koushiniku/bv6502/schematics/docs/bv6502_hw.pdf

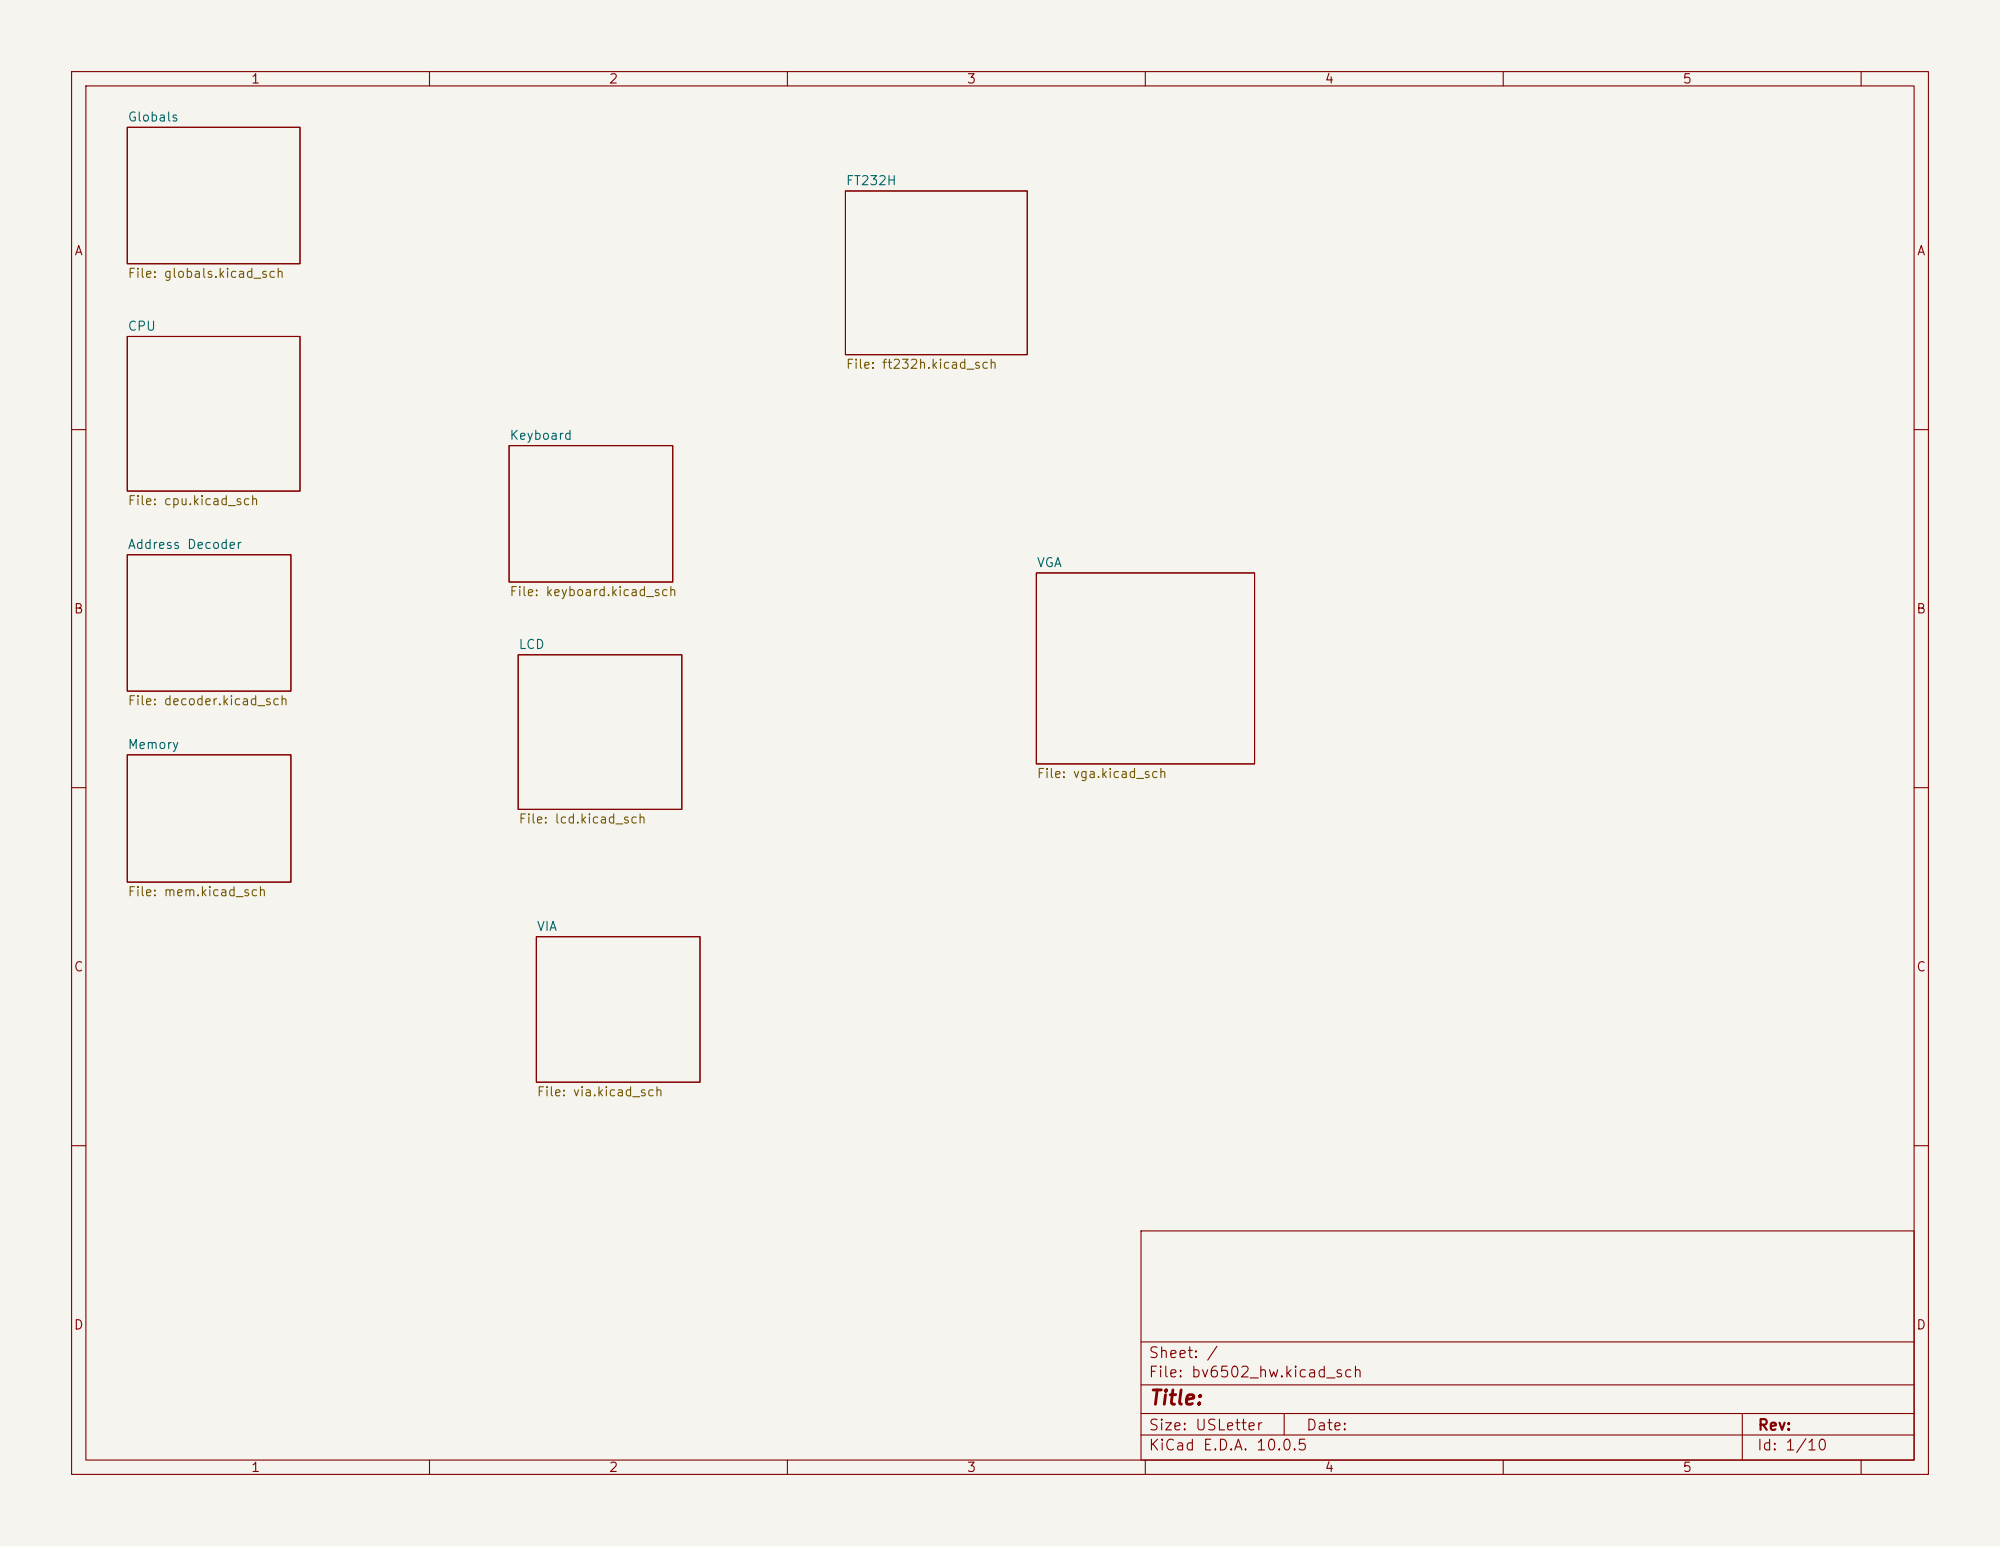
[picture p1: page 1]

Address Decoder File: decoder.kicad_sch Memory File: mem.kicad_sch CPU

Size: USLetter | Rev:
KiCad E.D.A. 10.0.5 | Id: 1/10

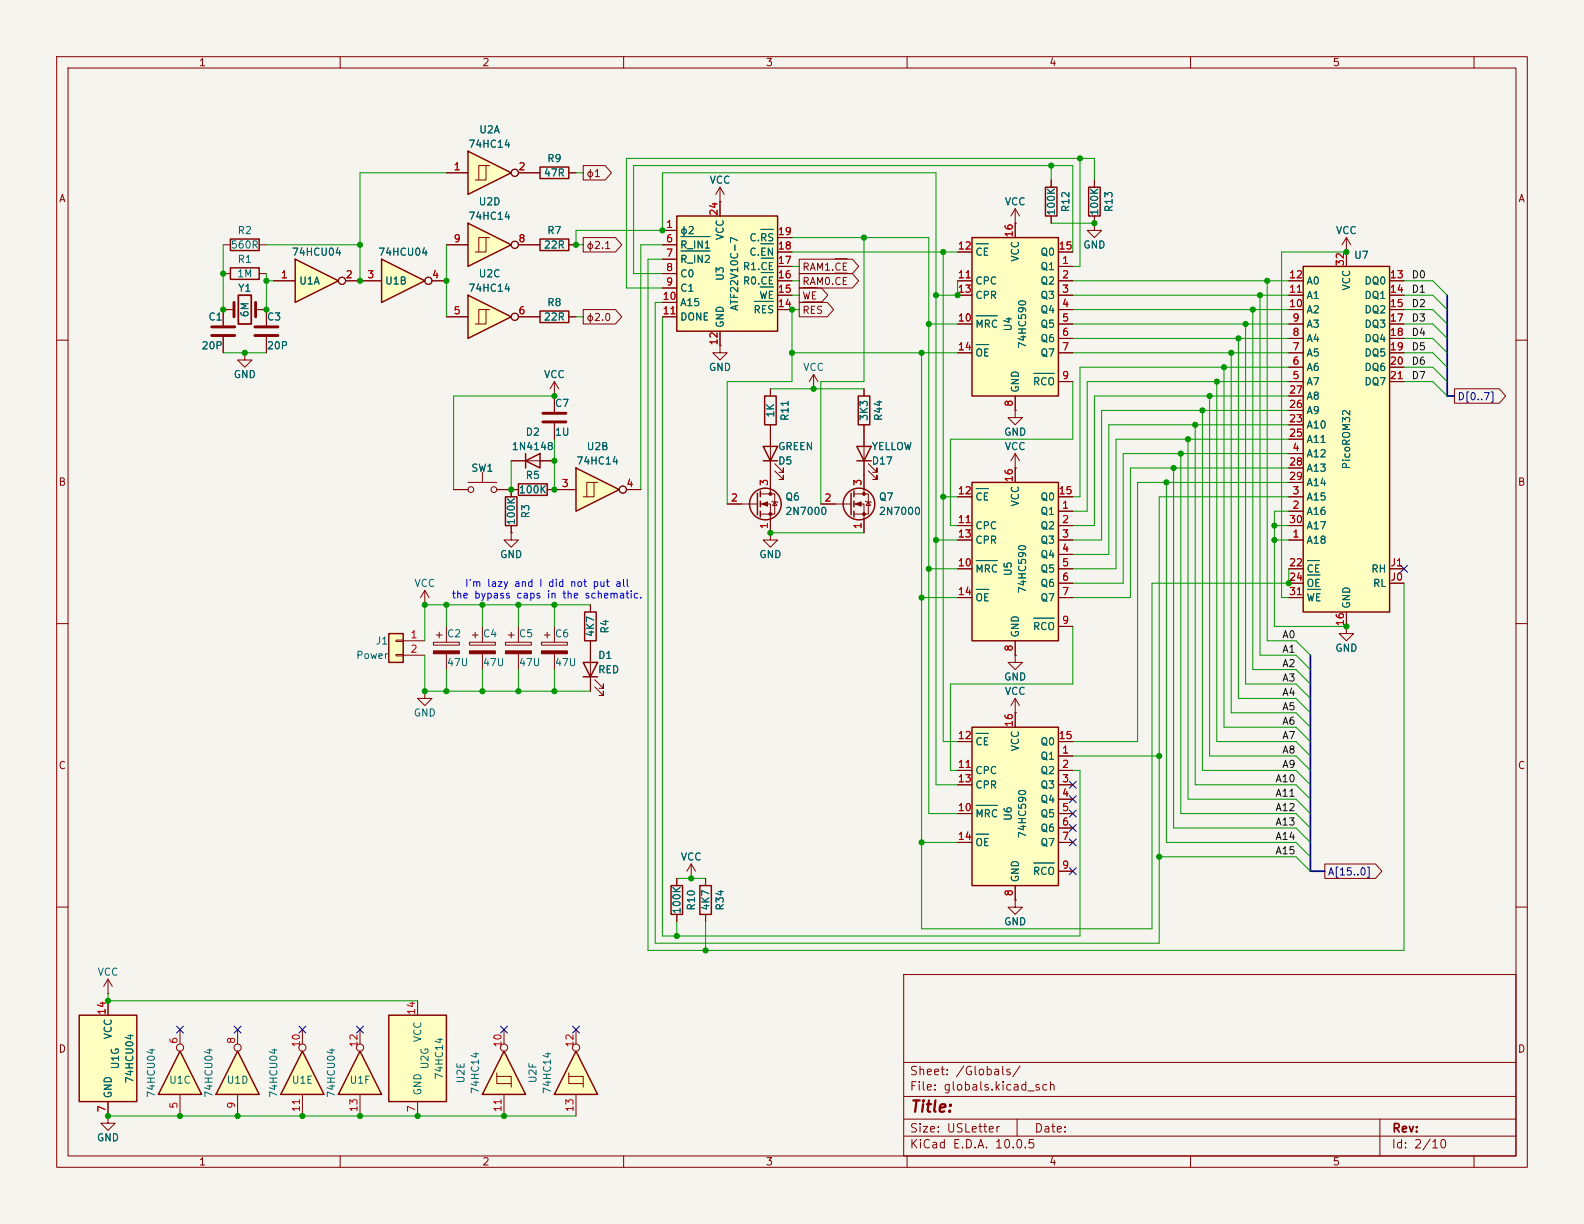
[picture p2: page 2]

A5 7
A6 6
A10 23 OE 24 A10 23 OE 24 A14 29 A14 29

VCC | | | A12 4

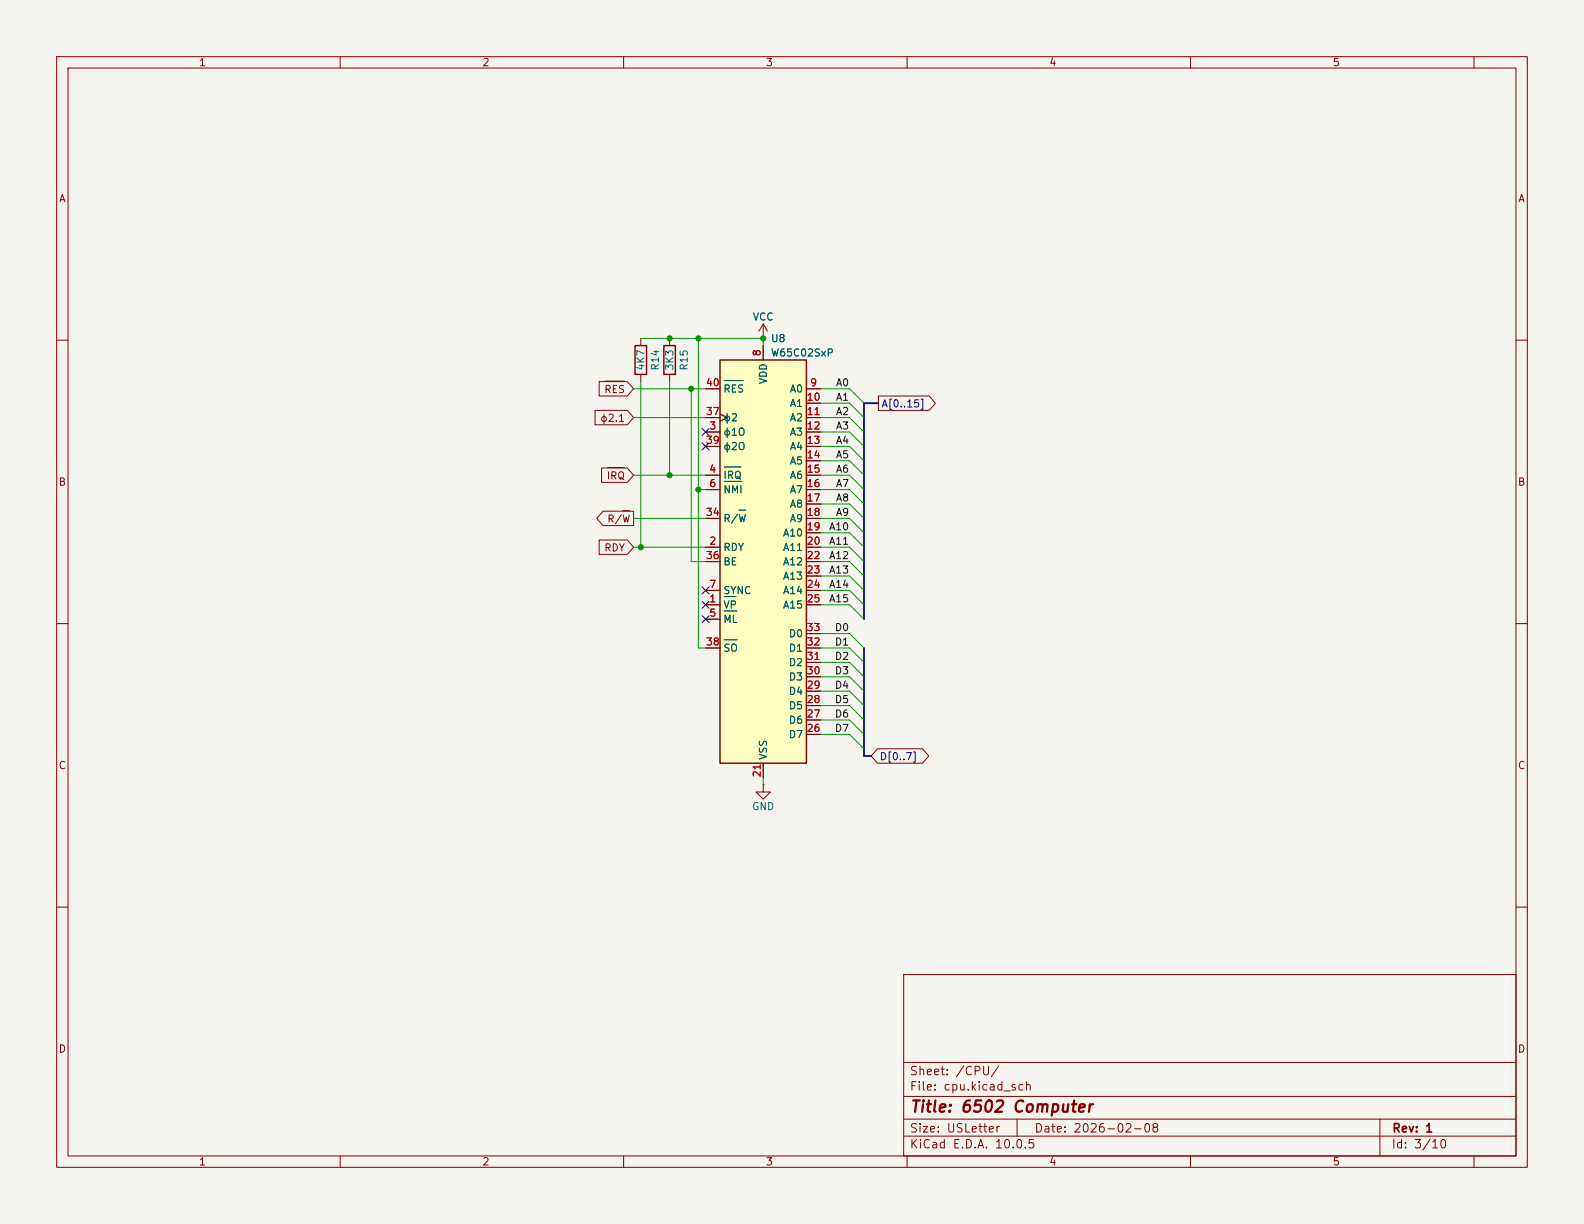
[picture p3: page 3]

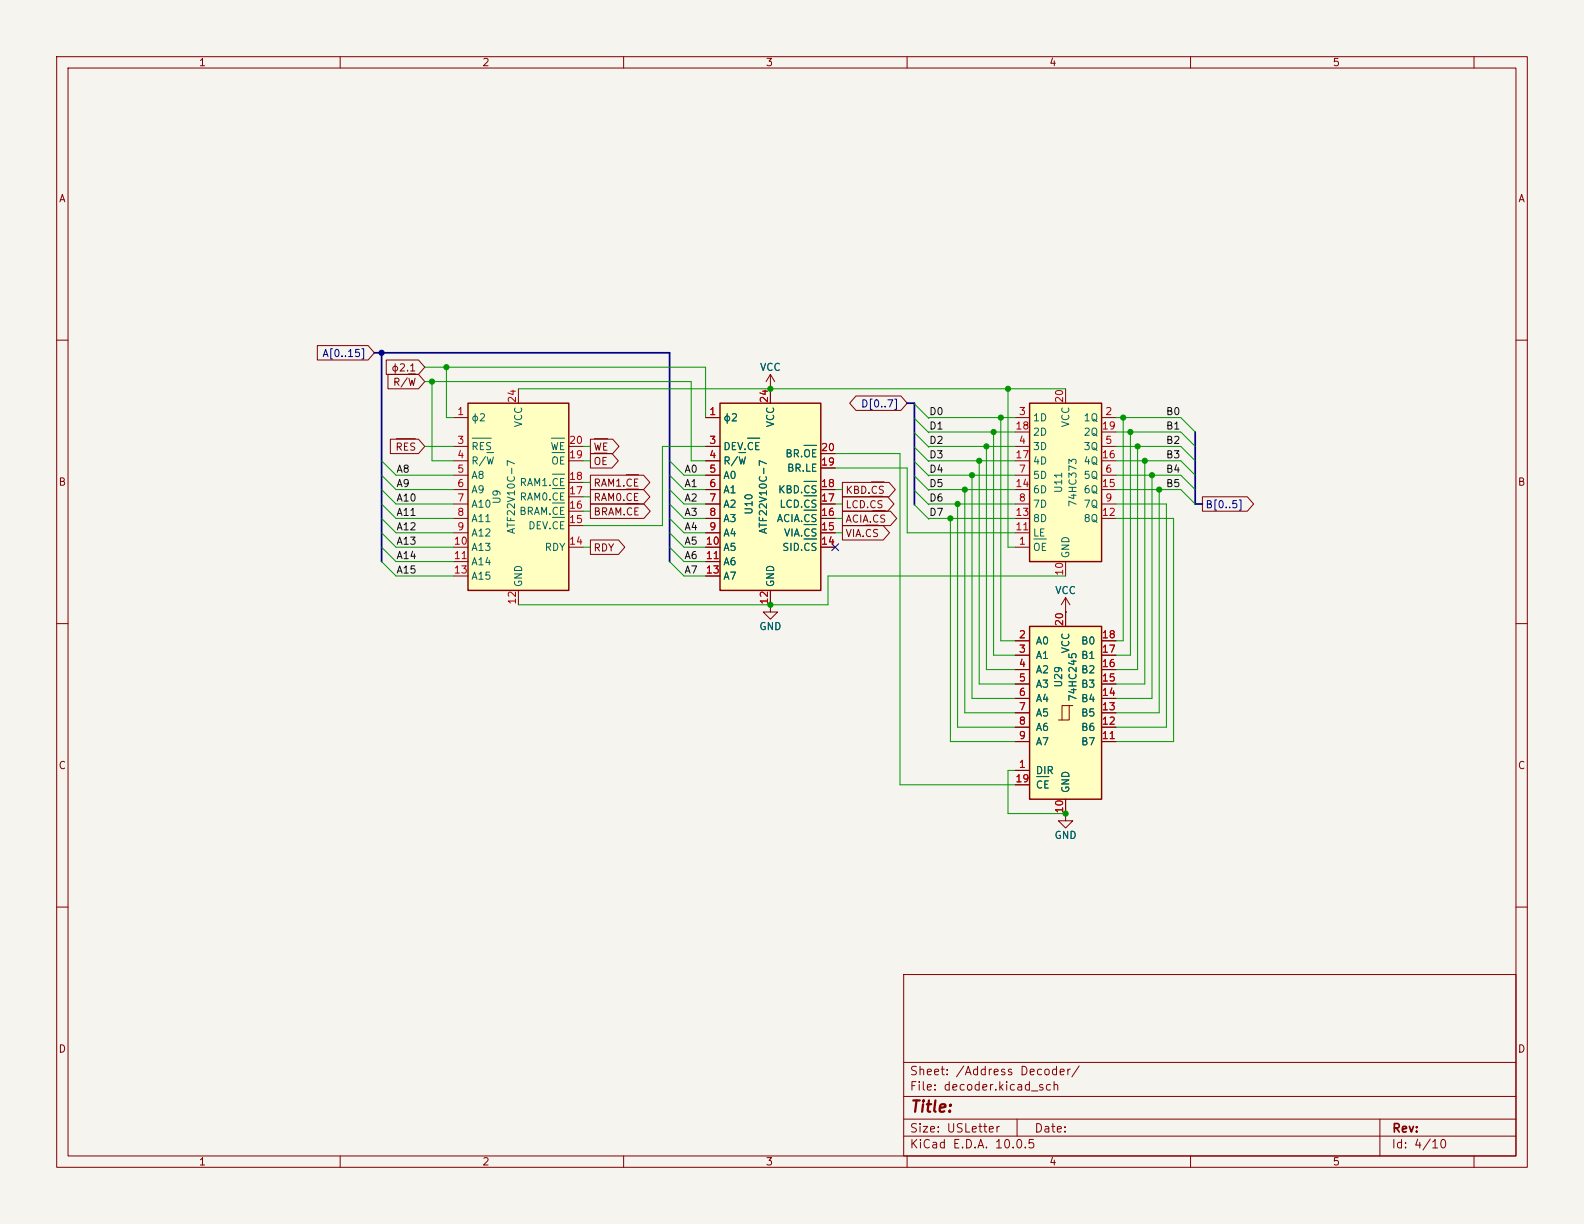
[picture p4: page 4]

VIA.CS D[0..7] RDY RAM1.CE ϕ2.1

VCC
SID.CS 14 VIA.CS 15 ACIA.CS 16 LCD.CS 17 KBD.CS 18 BR.LE 19 BR.OE 20 U10 ATF22V10C-7 GND

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

LCD.CS KBD.CS

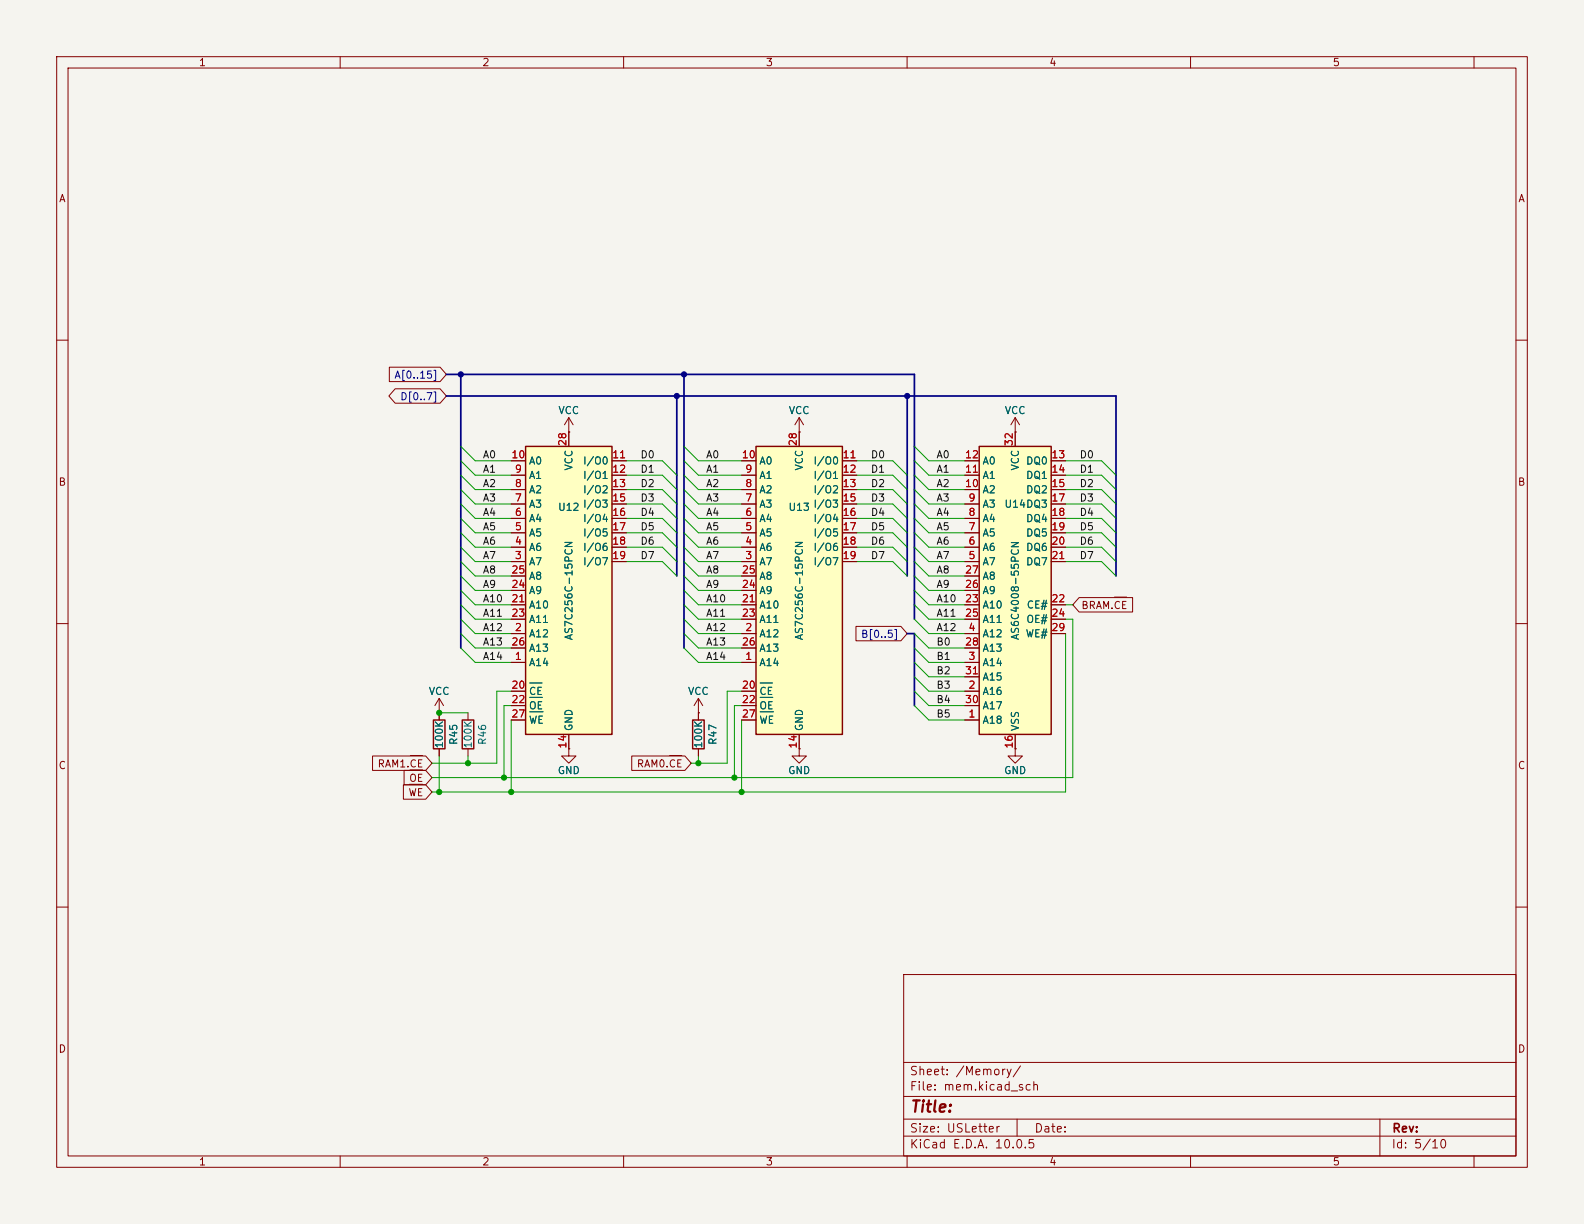
[picture p5: page 5]

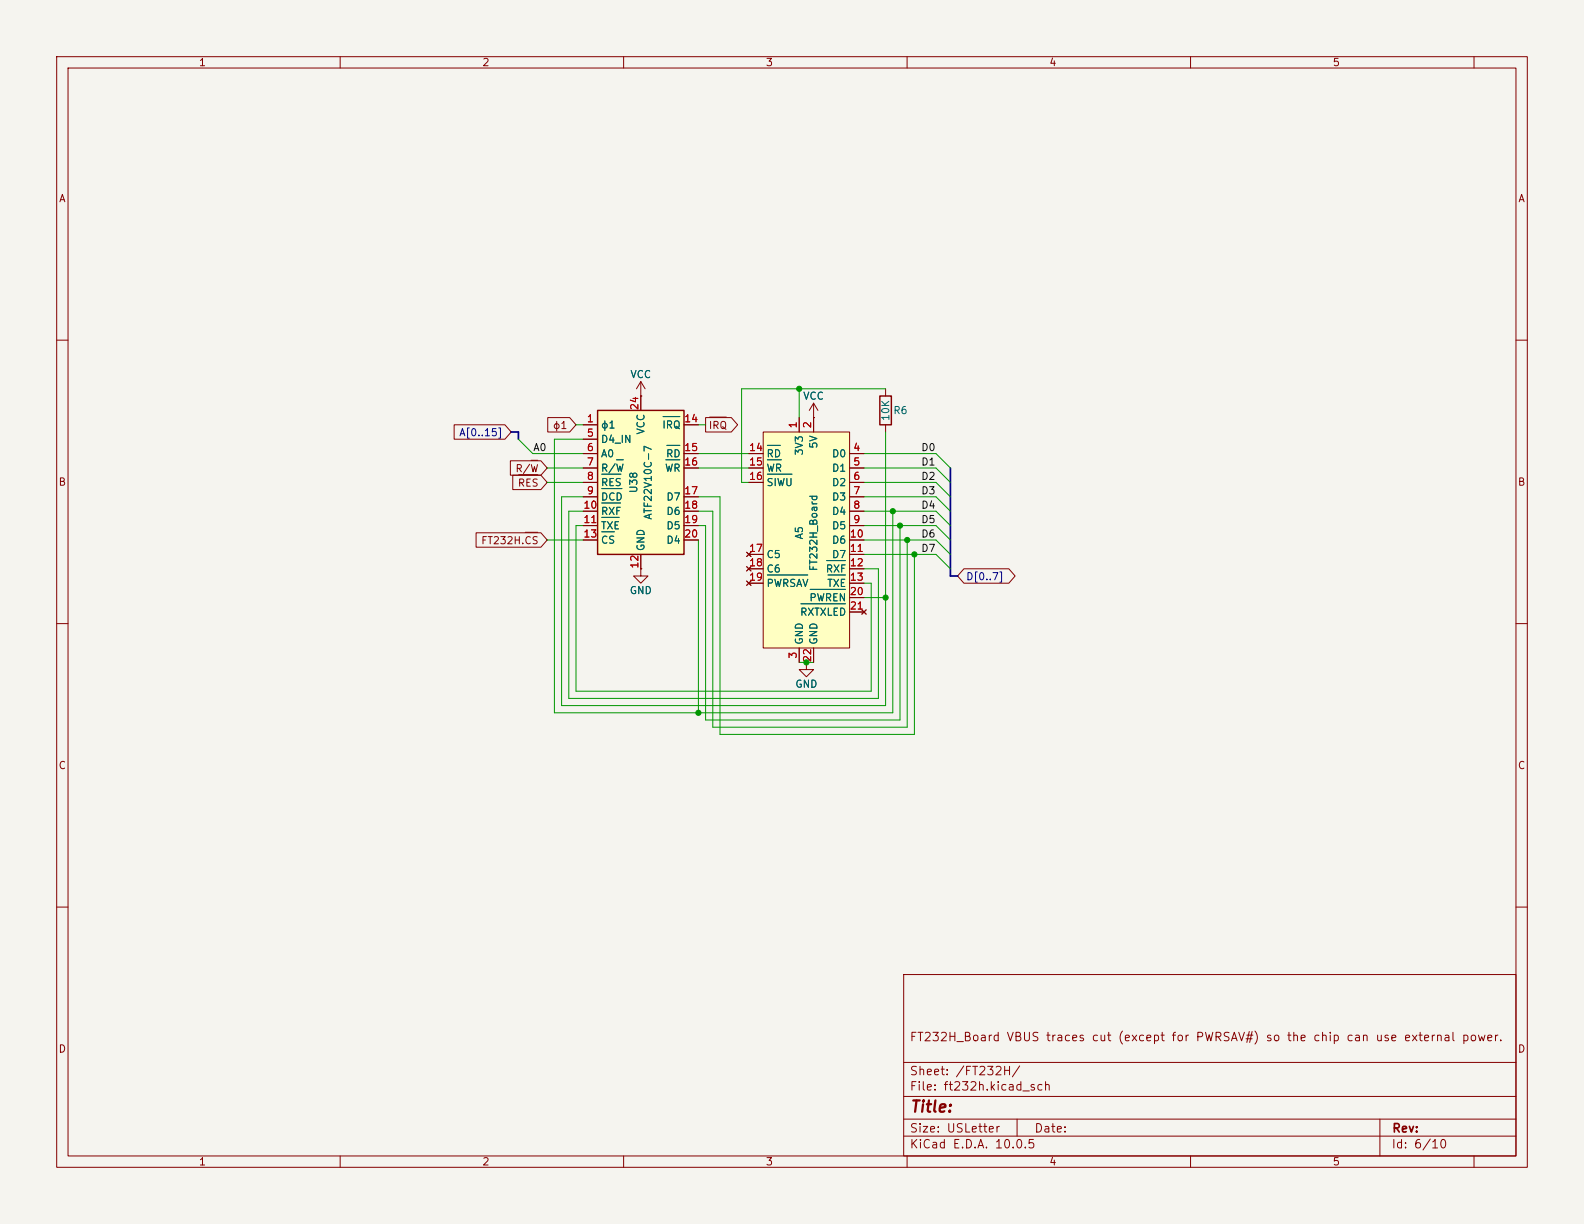
[picture p6: page 6]

VCCGND 12 VCC 24
IRQ 14 RD 15 WR 16 D7 17 D6 18 D5 19 D4 20 U38 ATF22V10C-7 GND

1 RXTXLED 21 GND U38 ATF22V10C-7 GND 12 VCC 24

FT232H_Board VBUS traces cut (except for PWRSAV#) so the chip can use external power. 5V 2 GND

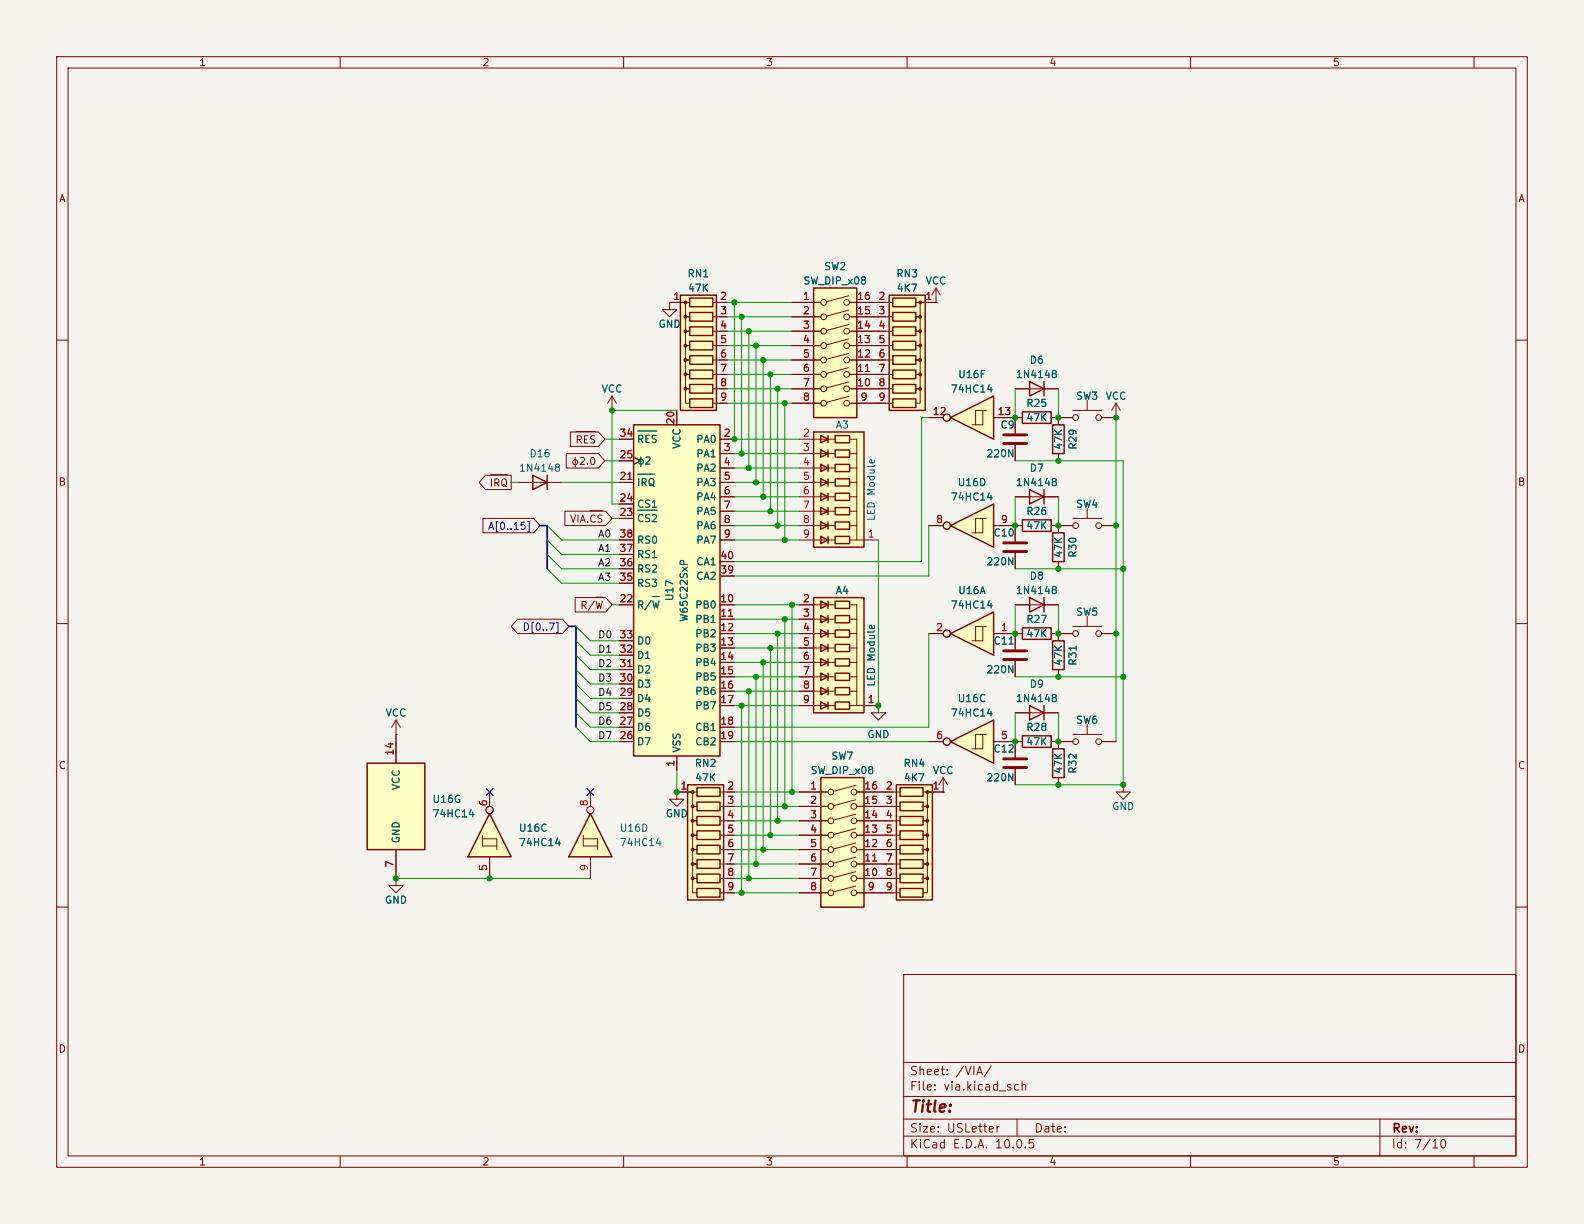
[picture p7: page 7]

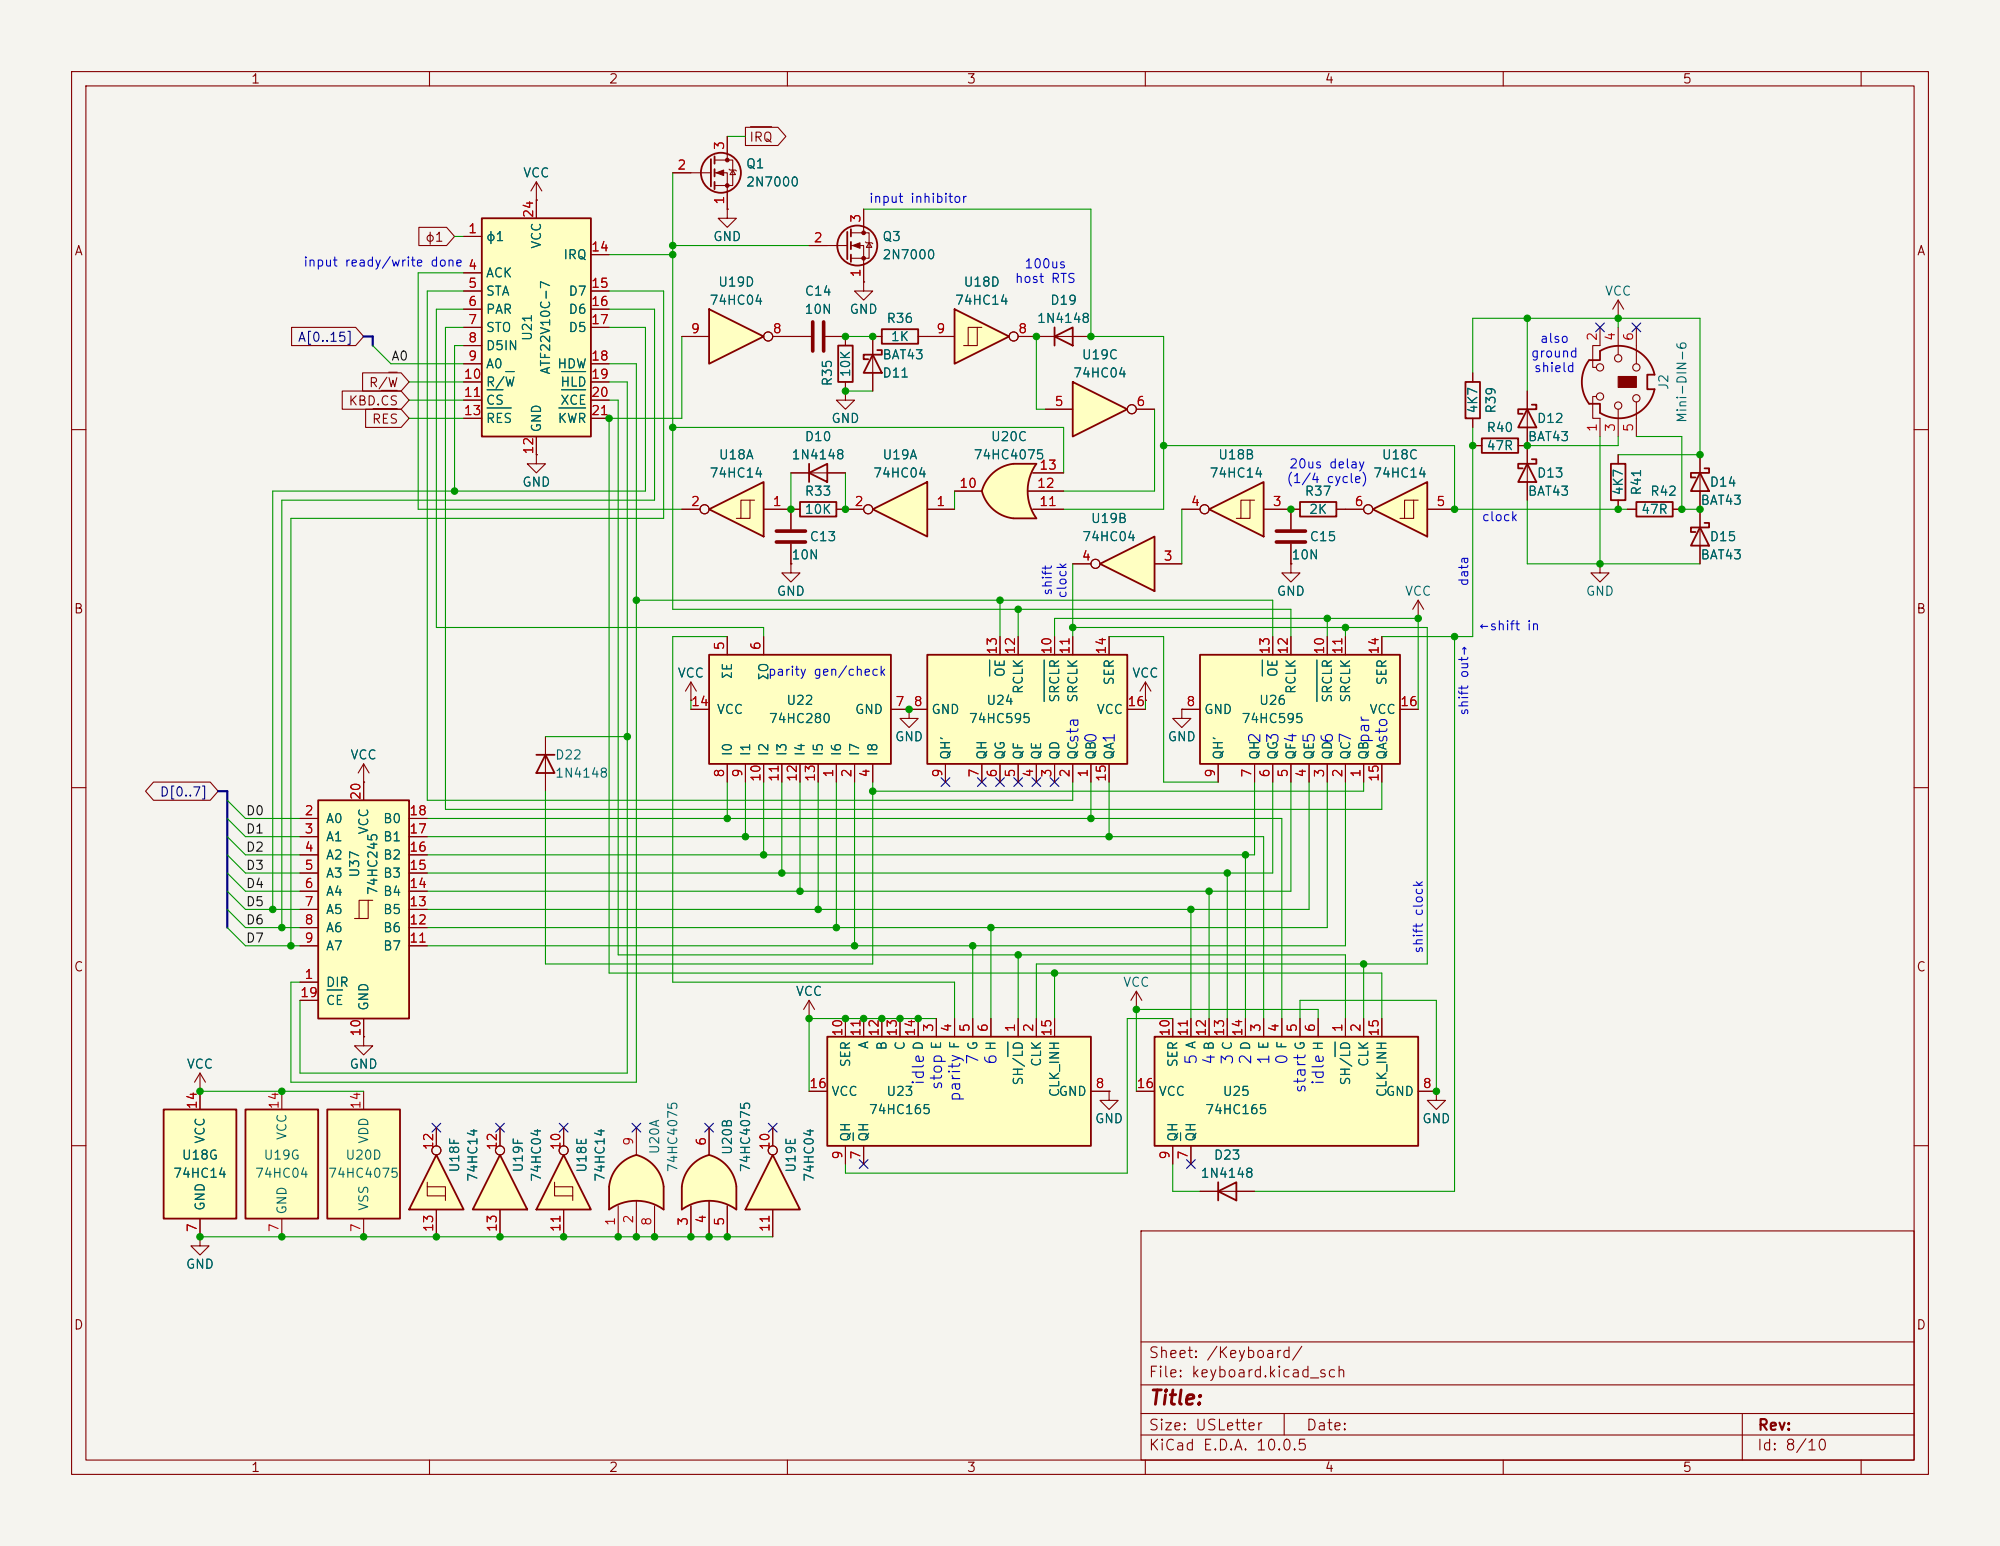
[picture p8: page 8]

input ready/write done

1 shift clock 100us host RTS

clock ←shift in data shift clock

7 GND 8 QH' 9 SRCLR 10 SRCLK 11 RCLK 12 OE 13 SER 14 QA 15

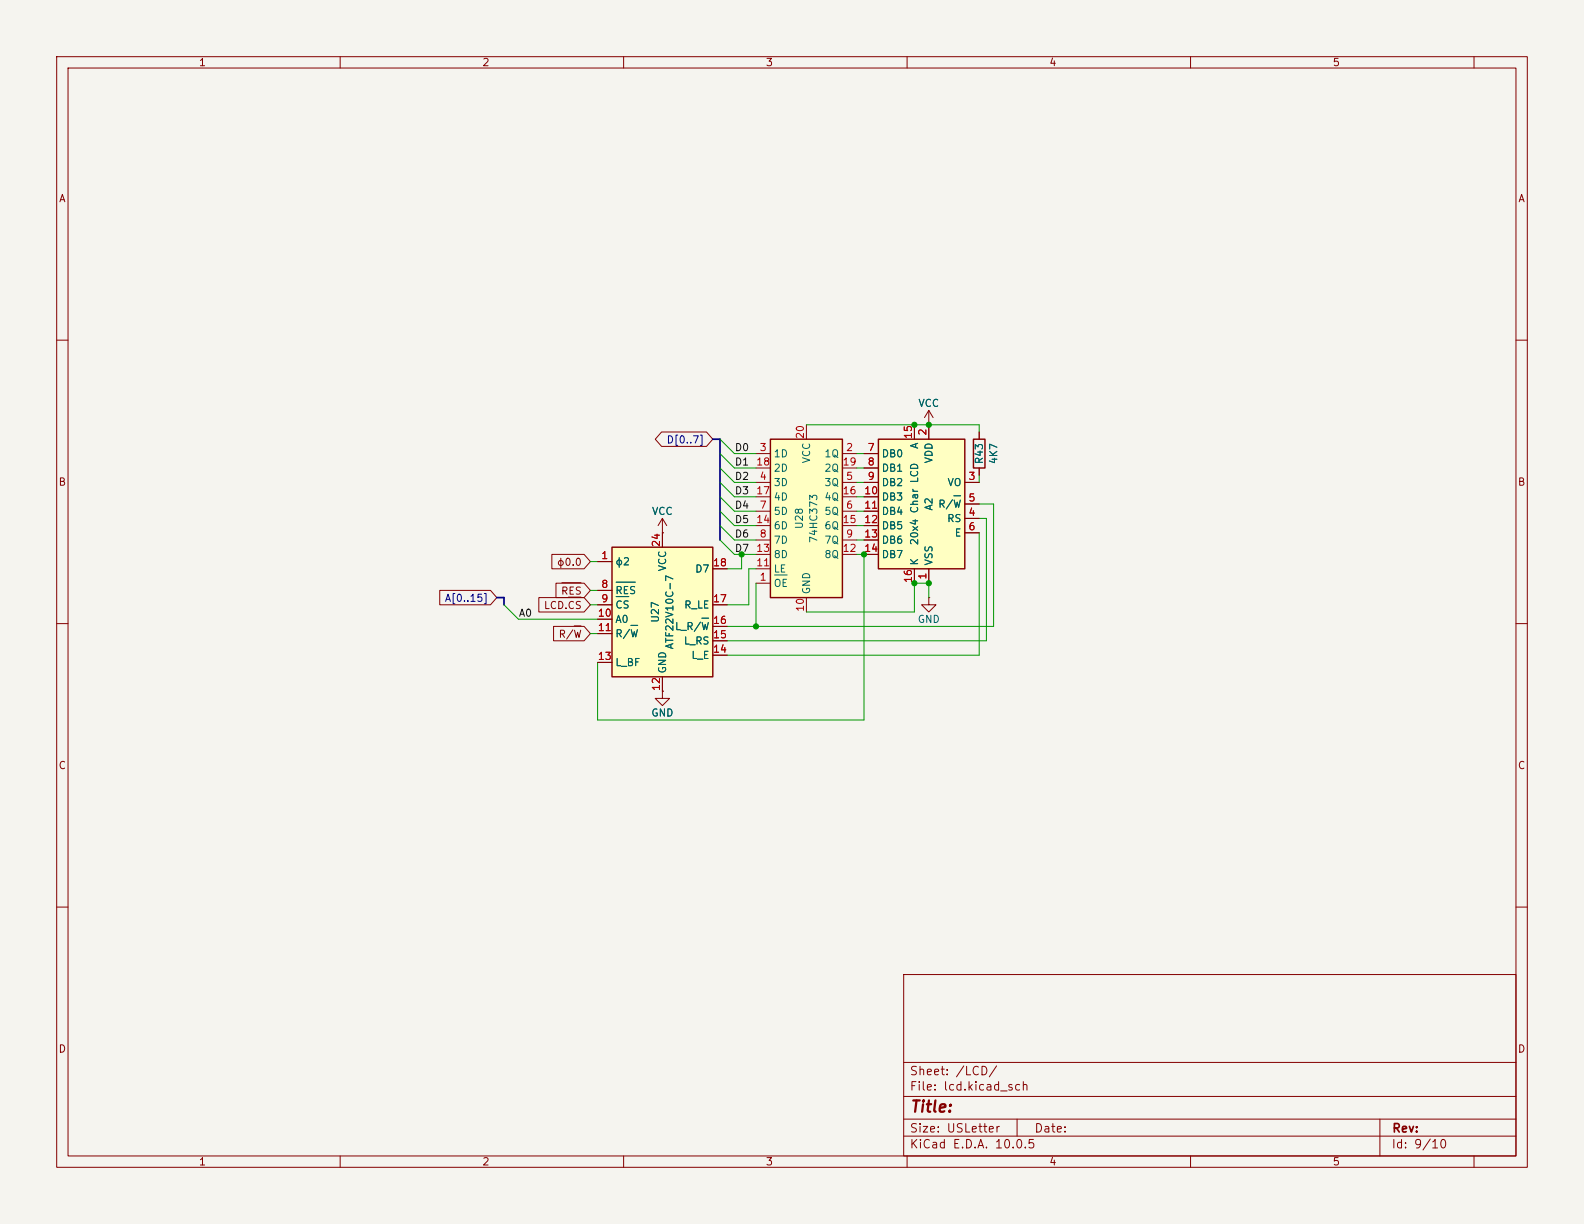
[picture p9: page 9]

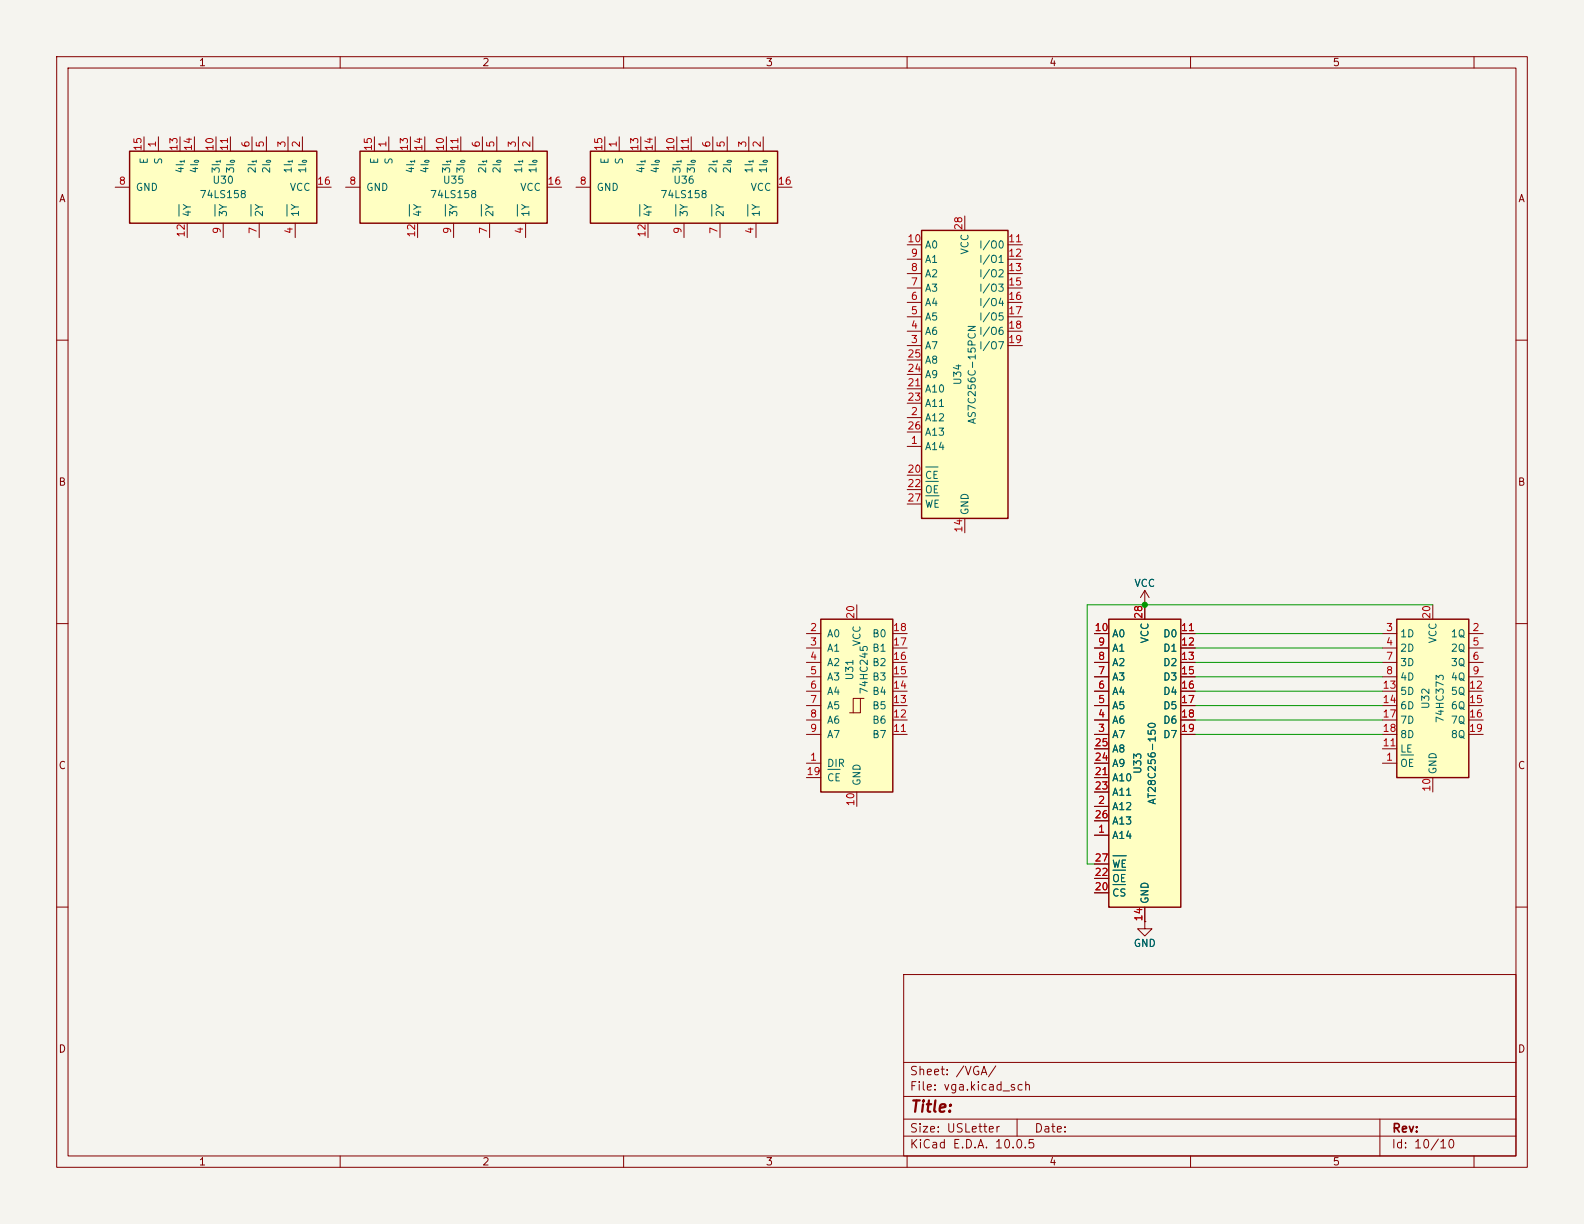
[picture p10: page 10]
