koushiniku/bv6502/(commit log)

2026-03-16 First commit. All is WIP.
    [bv6502.cfg, bv6502_hw.kicad_pcb, bv6502_hw.kicad_sch, cpu.kicad_sch, decoder.kicad_sch, globals.kicad_sch, kbd_lcd.kicad_sch, mem.kicad_sch]
2026-03-16 Moving in more files.
    [address_decoder.ods]
2026-03-17 File header adjust.
    [bv6502.cfg]
2026-03-19 LCD fixes
    [bv6502.cfg]
2026-04-23 lcd_cur_sync was really wrong
    [bv6502.cfg, bv6502_hw.kicad_sch, cpu.kicad_sch, decoder.kicad_sch, globals.kicad_sch, kbd_lcd.kicad_sch, mem.kicad_sch, uart.kicad_sch]
2026-04-23 improved keyboard termination
    [kbd_lcd.kicad_sch]
2026-04-26 line wrap fixes, keyboard rewire due to slow rise time
    [kbd_lcd.kicad_sch]
2026-04-29 LCD works with 4 MHz PHI2
    [kbd_lcd.kicad_sch]
2026-04-30 fixed cr and lf to match what conio expects. added backspace support.
    [kbd_lcd.kicad_sch]
2026-05-01 i can type lowercase! added tab key support and fixed cr and lf
    [kbd_lcd.kicad_sch, uart.kicad_sch]
2026-05-02 trying to make it automatically hold reset during power-on. it's a little better
    [decoder.kicad_sch, globals.kicad_sch, kbd_lcd.kicad_sch]
2026-05-02 removed unnecessary clock inversion
    [decoder.kicad_sch, globals.kicad_sch]
2026-05-03 progress fixing caps lock led
    [kbd_lcd.kicad_sch]
2026-05-03 kicad was open
2026-05-04 rewired the keyboard to remove 74HC245
    [kbd_lcd.kicad_sch]
2026-05-20 Address decoder pld file and no-VIA keyboard schematic and pld file.
    [address_decoder.ods, bv6502.cfg, bv6502_hw.kicad_sch, cpu.kicad_sch, decoder.kicad_sch, globals.kicad_sch, kbd_lcd.kicad_sch, mem.kicad_sch]
2026-05-23 PLD files and schematics for address decoder, device selector, keyboard controller, lcd controller, banked memory, and bootloader.
    [address_decoder.ods, bv6502_hw.kicad_sch, cpu.kicad_sch, decoder.kicad_sch, globals.kicad_sch, keyboard.kicad_sch, lcd.kicad_sch, mem.kicad_sch]
2026-05-26 keyboard, via, acia updates, ready to test
    [bv6502.cfg, bv6502_hw.kicad_sch, kbd_lcd.kicad_sch, keyboard.kicad_sch, uart.kicad_sch]
2026-05-26 reduced RDY pullup to 1K for speed (still might not be enough)
    [cpu.kicad_sch]
2026-05-28 added phi0 for write latch timing
    [bv6502_hw.kicad_sch, decoder.kicad_sch, globals.kicad_sch, keyboard.kicad_sch, lcd.kicad_sch, uart.kicad_sch]
2026-05-28 added acia shematic and schematic pdf
    [via.kicad_sch]
2026-05-29 fixes to bootloader; finished via schematic
    [cpu.kicad_sch, globals.kicad_sch, keyboard.kicad_sch, lcd.kicad_sch, via.kicad_sch]
2026-05-29 update schematic
2026-05-30 fix keyboard irq clear
    [keyboard.kicad_sch]
2026-05-30 updating schematics as I wire the board
    [cpu.kicad_sch, decoder.kicad_sch, globals.kicad_sch, keyboard.kicad_sch, lcd.kicad_sch, mem.kicad_sch, uart.kicad_sch, via.kicad_sch]
2026-06-02 forgot bank register transciever so now it's write-only
    [decoder.kicad_sch, globals.kicad_sch]
2026-06-04 added back bus transceiver for devsel
    [decoder.kicad_sch]
2026-06-08 fixing wiring
    [bv6502_hw.kicad_sch, decoder.kicad_sch, globals.kicad_sch, keyboard.kicad_sch, lcd.kicad_sch]
2026-06-09 adding vga
    [vga.kicad_sch]
2026-06-10 pullup/pulldown on dip switch
    [cpu.kicad_sch, via.kicad_sch]
2026-06-11 combined reset inputs in the pld
    [globals.kicad_sch, keyboard.kicad_sch]
2026-06-12 removed the 74hc04 from the keyboard
    [keyboard.kicad_sch]
2026-06-12 re-added the 74hc04 to the keyboard
    [keyboard.kicad_sch]
2026-06-14 my keyboard needed a transceiver after all :(
    [cpu.kicad_sch, decoder.kicad_sch, globals.kicad_sch, keyboard.kicad_sch, lcd.kicad_sch, uart.kicad_sch, via.kicad_sch]
2026-06-15 done wiring
    [keyboard.kicad_sch]
2026-06-15 added some picorom and pld writing stuff to makefiles
    [globals.kicad_sch, mem.kicad_sch]
2026-06-21 clock improvements
    [cpu.kicad_sch, decoder.kicad_sch, globals.kicad_sch, keyboard.kicad_sch, lcd.kicad_sch, mem.kicad_sch, uart.kicad_sch, via.kicad_sch]
2026-06-26 ditched phi0, dropped to 6MHz
    [decoder.kicad_sch, globals.kicad_sch, keyboard.kicad_sch, lcd.kicad_sch]
2026-06-27 debugging LCD
    [lcd.kicad_sch]
2026-06-28 keyboard input works
    [globals.kicad_sch, keyboard.kicad_sch]
2026-06-29 keyboard output debug--still WIP
    [globals.kicad_sch, keyboard.kicad_sch]
2026-07-03 keyboard LEDs work
    [decoder.kicad_sch, keyboard.kicad_sch]
2026-07-04 ACIA works! Everything works!
    [uart.kicad_sch]
2026-07-08 new ft232h wip
    [bv6502_hw.kicad_sch, ft232h.kicad_sch]
2026-08-01 new ft245 support
    [bv6502_hw.kicad_sch, cpu.kicad_sch, ft232h.kicad_sch]
